HexabitzPlatform/H1DR2x-Hardware/README.md

# H1DR2x-Hardware
Hexabitz CAN Transceiver Module Hardware Design
