HexabitzPlatform/H1DR2x-Hardware/H1DR21/Released/BOM/H1DR21.xlsx

 |  | www.hexabitz.com info@hexabitz.com |  | Bill Of Materials
Customer | Hexabitz | Revision | 1
Project | Hexabitz Modules | Date | 2024-11-12
Board | 3.3V CAN Transceiver (H1DR2x) | Notes
Designator | Description | Manufacturer Part Number | Manufacturer | Octopart Url | Quantity
RESET | Headers & Wire Housings Unshrouded 1 POS T/H | 5-146280-1 | TE Connectivity | https://octopart.com/5-146280-1-te+connectivity+%2F+amp-40259676?r=sp | 1
SWD | Conn Unshrouded Header HDR 3 POS 2.54mm Solder ST Top Entry Thru-Hole Carton | 5-146281-3 | TE Connectivity | https://octopart.com/5-146281-3-te+connectivity+%2F+amp-39745942?r=sp | 1
R1 | RES SMD 0.0OHM JUMPER 1/10W 0603 | RC0603JR-070RL | YAGEO [VR] | https://octopart.com/rc0603jr-070rl-yageo-1241539?r=sp | 1
R4 | DNP RES 0 OHM JUMPER 1/10W 0603 | RC0603JR-070RL | Yageo | https://octopart.com/rc0603jr-070rl-yageo-1241539 | 1
R5 | RES SMD 120 OHM 1% 1/10W 0603 | AC0603FR-07120RL | Yageo | https://octopart.com/ac0603fr-07120rl-yageo-25738064 | 1
R2, R8, R9 | 270.0R Thick Film Resistors - SMD 0603 | RC0603FR-07270RL | Yageo | https://octopart.com/rc0603fr-07270rl-yageo-9288890?r=sp | 3
R3 | RES 10K Ohm 1% 0603 | CRCW060310K0JNEB | Vishay | https://octopart.com/crcw060310k0jneb-vishay+dale-46603268 | 1
C3,C5,C6, C10 | CAP CER 0.1UF 25V X7R 0603 | C0603C104K8RACTU | KEMET | https://octopart.com/c0603c104k8ractu-kemet-145075?r=sp&s=9bS9ASSwSEqMCE9KBEQZ0g | 4
C1 | CAP CER 1 UF 16V X7R 0805 | CC0805KKX7R7BB105 | YAGEO [VA] | https://octopart.com/cc0805kkx7r7bb105-yageo-8376555?r=sp | 1
C4 | CAP CER 4.7UF 25V X6S 0805 | GRM21BC81E475KA12L | Murata | https://octopart.com/grm21bc81e475ka12l-murata-10331911?r=sp&s=RY3qZSD8T6mG6TC9CHI5qQ | 1
FB1 | FERRITE BEAD 30 OHM 0603 1LN | MMZ1608Y300BTA00 | TDK | https://octopart.com/mmz1608y300bta00-tdk-7906990?r=sp | 1
D1 | LED Uni-Color Super Red 639nm 2-Pin Chip 0603(1608Metric) T/R | VLMS1300-GS08 | Vishay | https://octopart.com/vlms1300-gs08-vishay-21709201?r=sp | 1
D2 | LED Uni-Color Soft Orange 611nm 2-Pin Chip 0603(1608Metric) T/R | VLMY1300-GS08 | Vishay | https://octopart.com/vlmo1300-gs08-vishay-21709200?r=sp | 1
D3 | LED Uni-Color Soft Yellow 611nm 2-Pin Chip 0603(1608Metric) T/R | VLMY1300-GS08 | Vishay | https://octopart.com/vlmy1300-gs08-vishay-21709204?r=sp | 1
D5 | TVS DIODE 3,3V 10,9V SOD323 | CDSOD323-T03SC | Bourns | https://octopart.com/cdsod323-t03sc-bourns-10487153?r=sp | 1
U1 | MCU 32-bit ARM Cortex M0+ RISC 512KB Flash 1.8V/2.5V/3.3V 48-Pin UFQFPN EP Tray | STM32G0B1CEU6 | STMicroelectronics | https://octopart.com/stm32g0b1ceu6-stmicroelectronics-116363364?r=sp | 1
U2 | EAR99 TCAN334 Tape & Reel (TR) CANbus interface transceiver 120mV 1.45mm 1Mbps -40C~125C | TCAN334DCNT | Texas Instruments | https://octopart.com/tcan334dcnt-texas+instruments-70835167 | 1
P1 | Modular Terminal Block, 15A, 1 Row(s), 1 Deck(s) | 1546111-2 | TE Connectivity | https://octopart.com/1546111-2-te+connectivity-40393355 | 1
X1 | 8,0000MHZ 33pF SMD MURATA Resonators | CSTNE8M00G550000R0 | Murata | https://octopart.com/cstne8m00g550000r0-murata-91406934?r=sp | 1
