HexabitzPlatform/H1DR2x-Hardware/H1DR21/Documentation/H1DR21.pdf

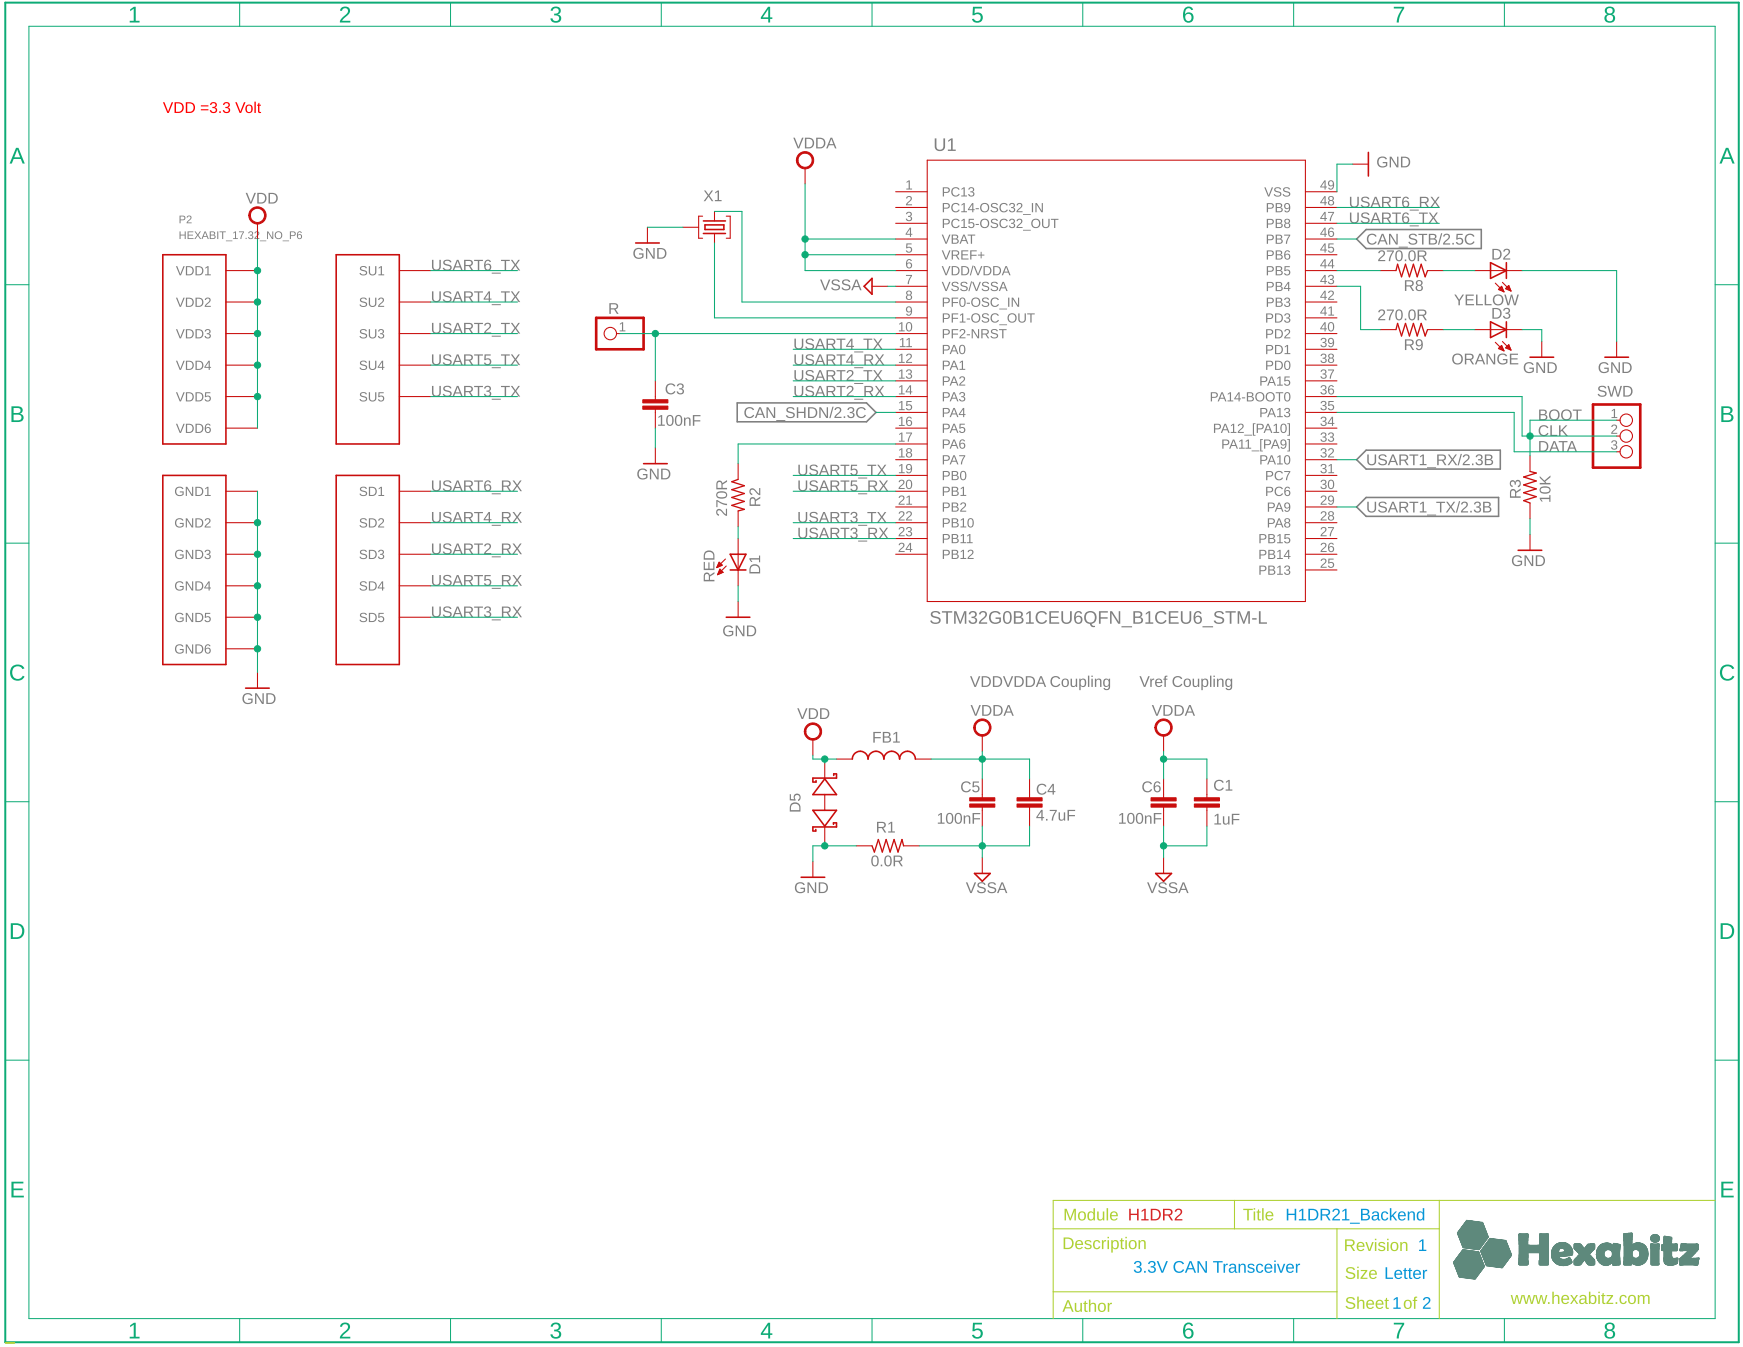
[picture p1: page 1]

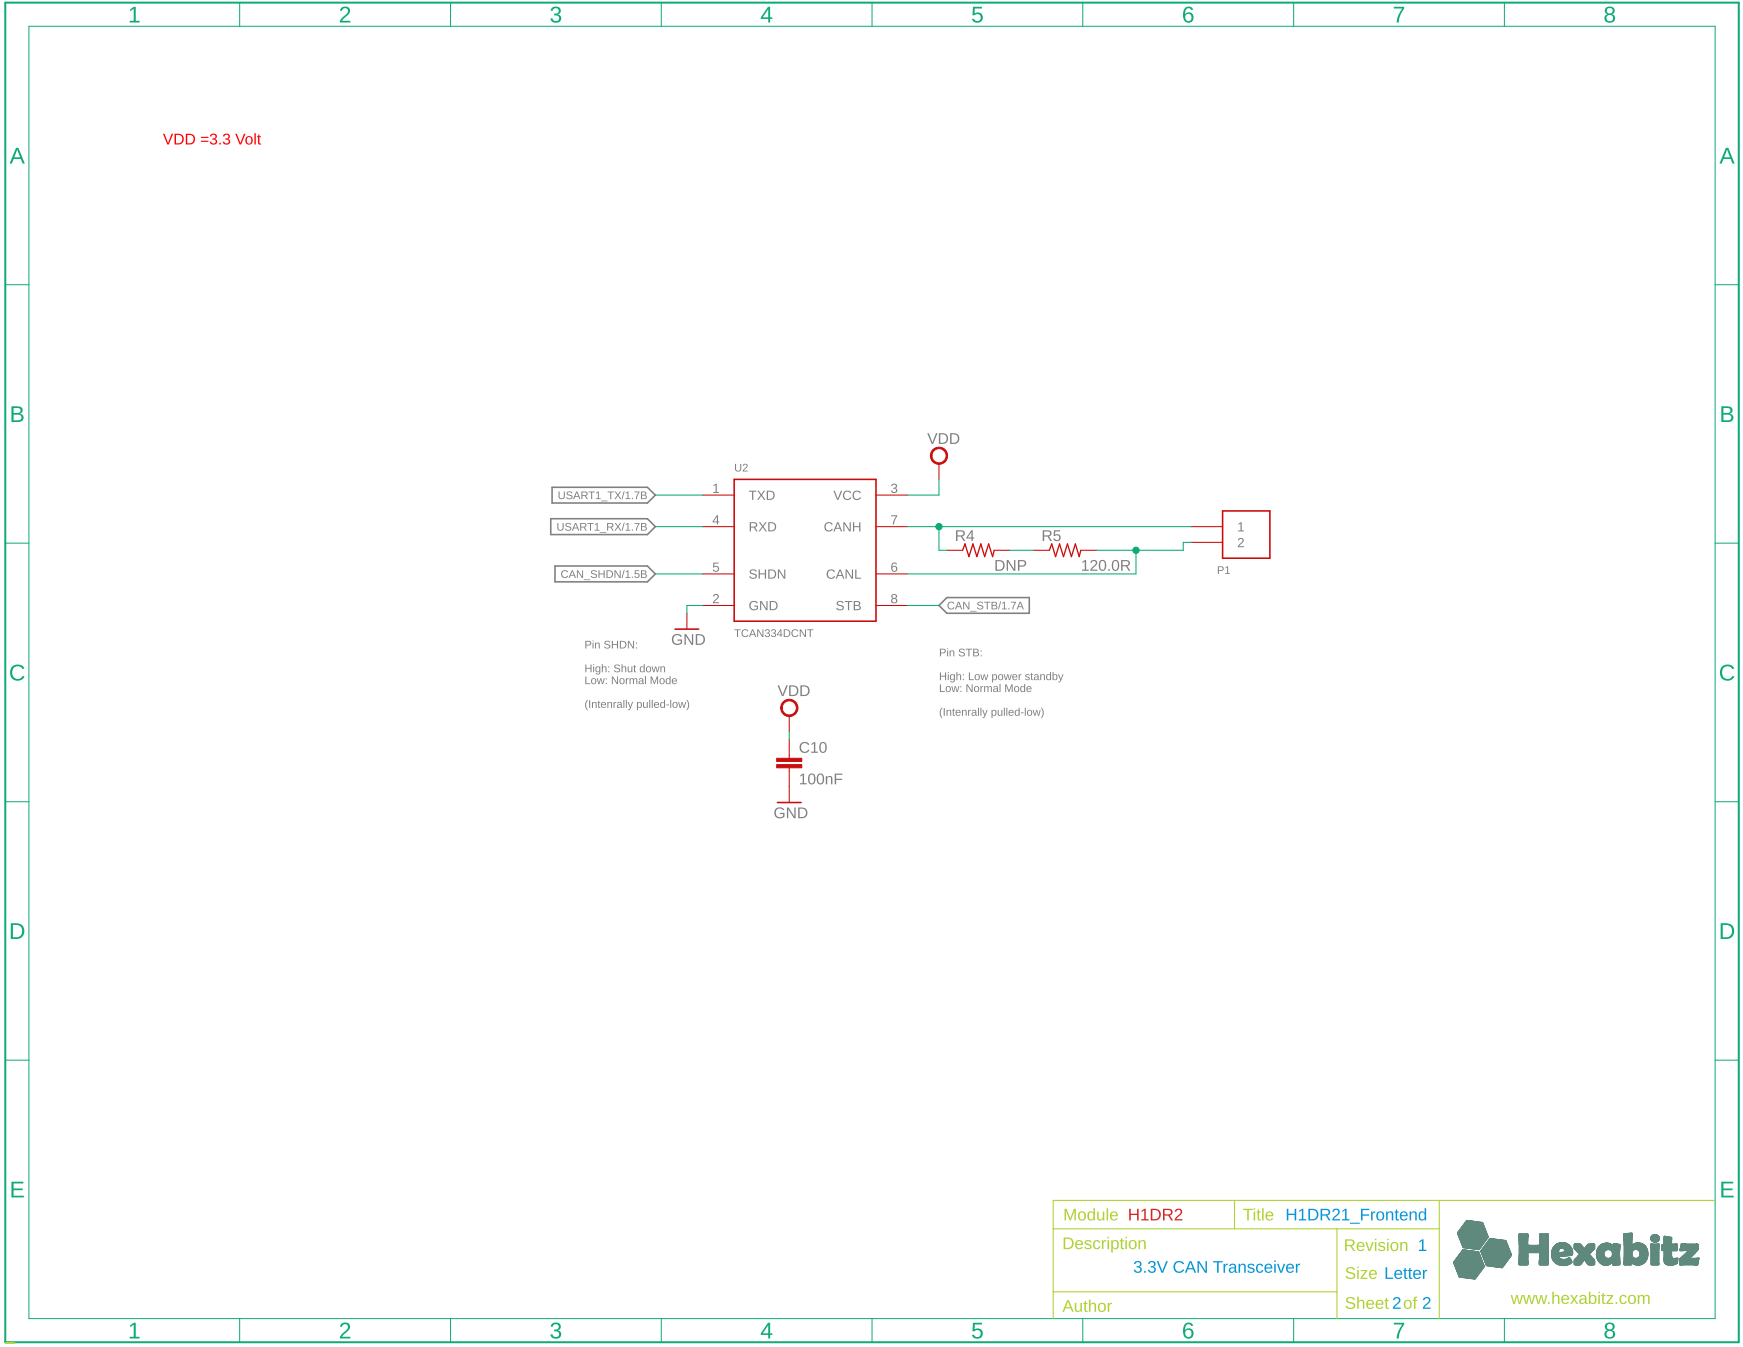
[picture p2: page 2]
