HexabitzPlatform/H1DR2x-Hardware/H1DR21/Design/H1DR21.brd

## EAGLE design H1DR21/Design/H1DR21.brd (2024-12-14)

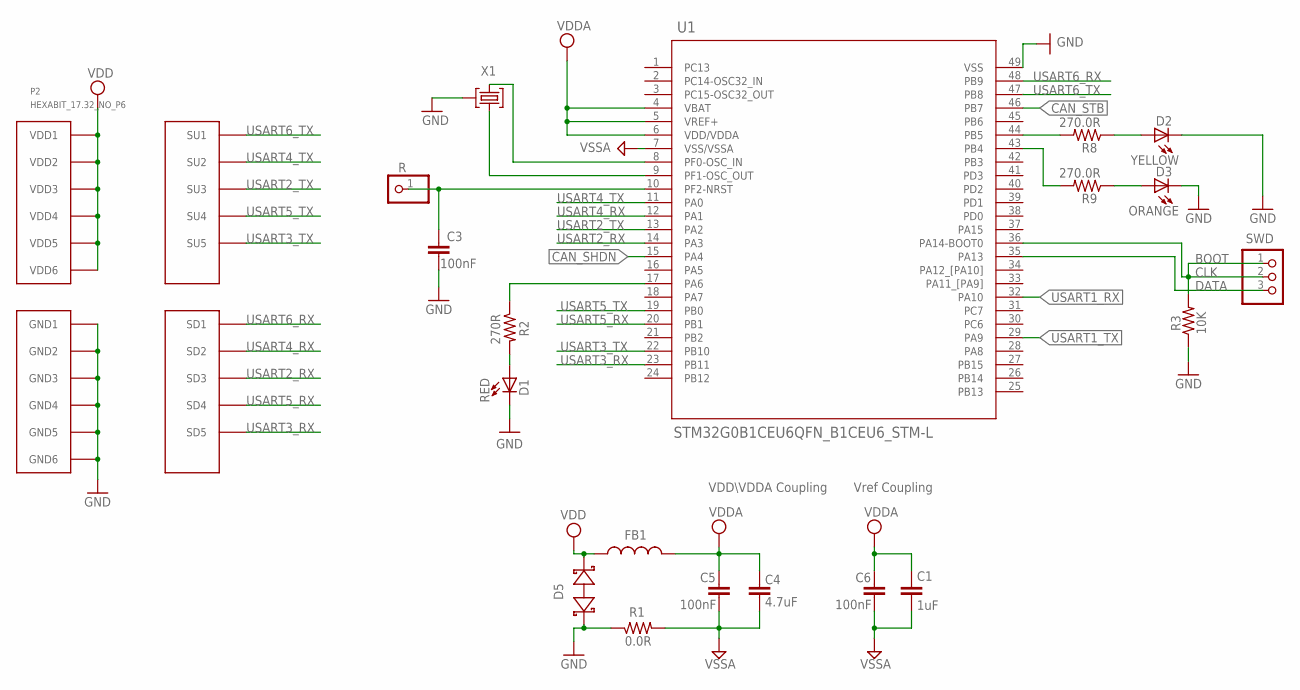
[picture p3: schematic H1DR21.sch, sheet 1]

Parts:
C1: 1uF; C-0805
C3, C5, C6: 100nF; C-0603
C4: 4.7uF; C-0805
D1: RED; VLMS1300-GS08; MPN VLMS1300-GS08
D2: YELLOW; VLMS1300-GS08
D3: ORANGE; VLMS1300-GS08
D5: BOURNS_CDSOD323-T03SCBOURNS_CDSOD323-T03SC_0_0; BOURNS_CDSOD323-T03SC_0
FB1: FB-TDK_MMZ1608Y300B; FB-0603; MPN MMZ1608Y300B
P2: HEXABIT_17.32_NO_P6
R: R; 1X01
R1: 0.0R; R-0603; MPN RC0603JR-070RL
R2: 270R; R-0603
R3: 10K; R-0603
R8, R9: 270.0R; R-0603
SWD: PINHD-1X3; 1X03
U1: STM32G0B1CEU6QFN_B1CEU6_STM-L; QFN_B1CEU6_STM-L
X1: XTALL_CSTCE8M00G52

Connections:
CAN_SHDN: U1.15 (PA4); also elsewhere on the board
CAN_STB: U1.46 (PB7); also elsewhere on the board
CLK: R3.2, SWD.1, SWD.2, U1.36 (PA14-BOOT0)
DATA: SWD.3, U1.35 (PA13)
GND: C3.2, D1.C, D2.C, D3.C, D5.1 (A), P2.PAD_PD7 (GND1), P2.PAD_PD8 (GND2), P2.PAD_PD9 (GND3), P2.PAD_PD10 (GND4), P2.PAD_PD11 (GND5), P2.PAD_PD12 (GND6), R1.1, R3.1, U1.49 (VSS), X1.P$2 (2); also elsewhere on the board
unnamed: D1.A, R2.2
unnamed: D3.A, R9.1
unnamed: R2.1, U1.17 (PA6)
unnamed: C3.1, R.1, U1.10 (PF2-NRST)
unnamed: U1.9 (PF1-OSC_OUT), X1.P$1 (1)
unnamed: U1.8 (PF0-OSC_IN), X1.P$3 (3)
unnamed: D2.A, R8.1
unnamed: R8.2, U1.44 (PB5)
unnamed: R9.2, U1.43 (PB4)
USART1_RX: U1.32 (PA10); also elsewhere on the board
USART1_TX: U1.29 (PA9); also elsewhere on the board
USART2_RX: P2.PAD_PD3 (SD3), U1.14 (PA3)
USART2_TX: P2.PAD_PU3 (SU3), U1.13 (PA2)
USART3_RX: P2.PAD_PD5 (SD5), U1.23 (PB11)
USART3_TX: P2.PAD_PU5 (SU5), U1.22 (PB10)
USART4_RX: P2.PAD_PD2 (SD2), U1.12 (PA1)
USART4_TX: P2.PAD_PU2 (SU2), U1.11 (PA0)
USART5_RX: P2.PAD_PD4 (SD4), U1.20 (PB1)
USART5_TX: P2.PAD_PU4 (SU4), U1.19 (PB0)
USART6_RX: P2.PAD_PD1 (SD1), U1.48 (PB9)
USART6_TX: P2.PAD_PU1 (SU1), U1.47 (PB8)
VDD: D5.2 (C), FB1.2, P2.PAD_PU7 (VDD1), P2.PAD_PU8 (VDD2), P2.PAD_PU9 (VDD3), P2.PAD_PU10 (VDD4), P2.PAD_PU11 (VDD5), P2.PAD_PU12 (VDD6); also elsewhere on the board
VDDA: C1.1, C4.1, C5.1, C6.1, FB1.1, U1.4 (VBAT), U1.5 (VREF+), U1.6 (VDD/VDDA)
VSSA: C1.2, C4.2, C5.2, C6.2, R1.2, U1.7 (VSS/VSSA)

Notes on the sheet:
Vref Coupling
VDD\VDDA Coupling
BOOT

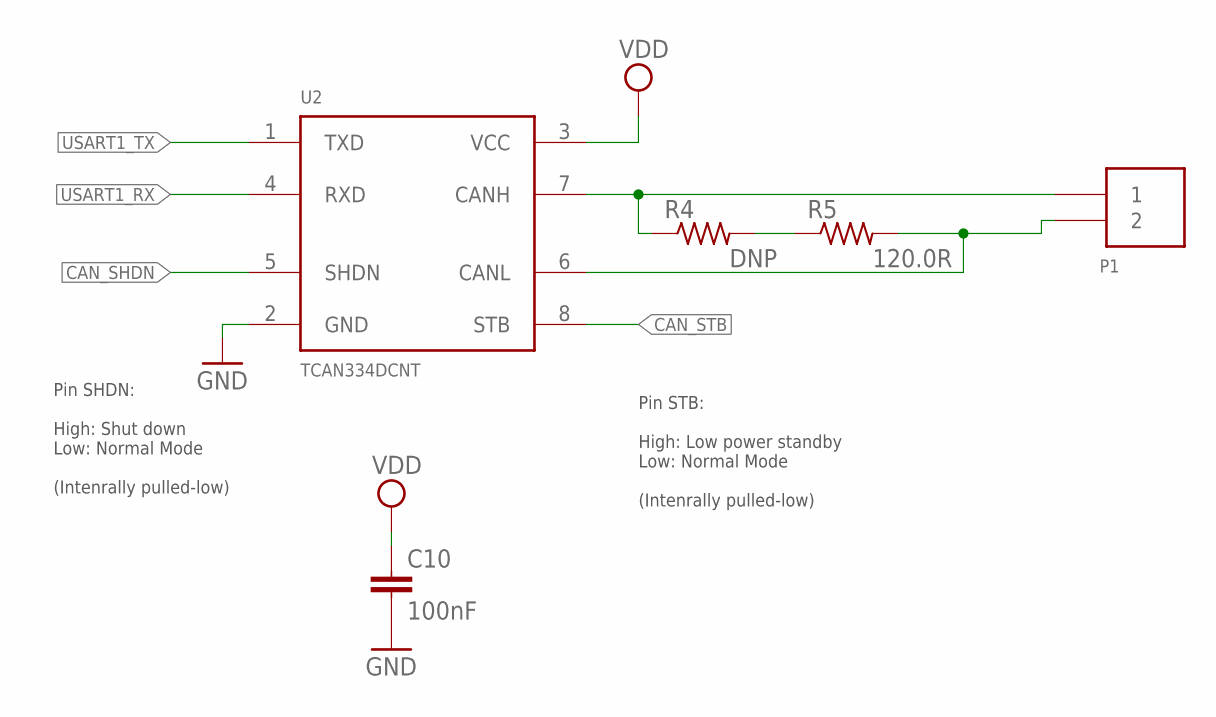
[picture p4: schematic H1DR21.sch, sheet 2]

Parts:
C10: 100nF; C-0603; TOLERANCE 10%; VOLTAGE_RATING 10V; MPN C0603C104K8RACTU
P1: 1546111-2
R4: DNP; R-0603; MPN RC0603JR-070RL
R5: 120.0R; R-0603; TOLERANCE 1%; MPN AC0603FR-07120RL
U2: TCAN334DCNT

Connections:
CAN_SHDN: U2.5 (SHDN); also elsewhere on the board
CAN_STB: U2.8 (STB); also elsewhere on the board
GND: C10.2, U2.2 (GND); also elsewhere on the board
unnamed: P1.1, R4.1, U2.7 (CANH)
unnamed: R4.2, R5.1
unnamed: P1.2, R5.2, U2.6 (CANL)
USART1_RX: U2.4 (RXD); also elsewhere on the board
USART1_TX: U2.1 (TXD); also elsewhere on the board
VDD: C10.1, U2.3 (VCC); also elsewhere on the board

Notes on the sheet:
Pin SHDN: High: Shut down Low: Normal Mode (Intenrally pulled-low)
Pin STB: High: Low power standby Low: Normal Mode (Intenrally pulled-low)

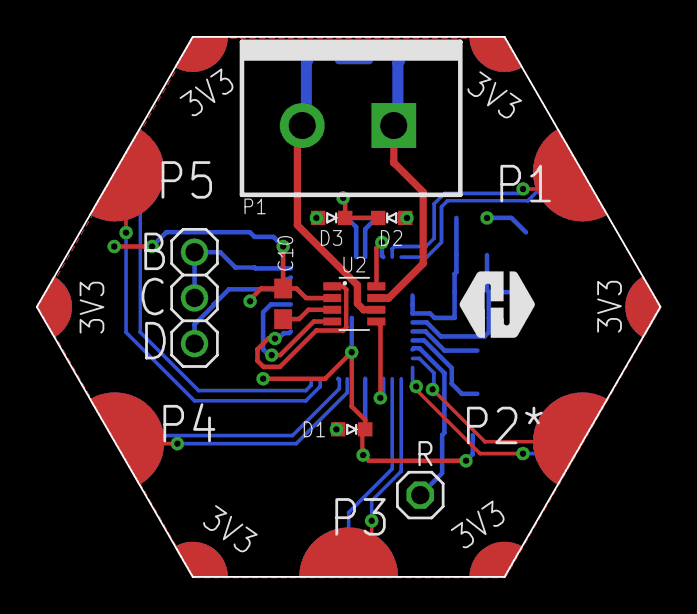
[picture p5: board H1DR21.brd from above]

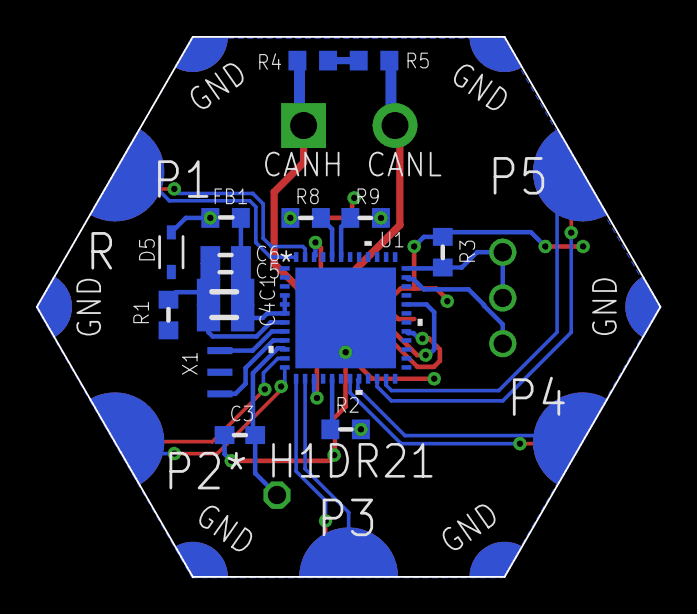
[picture p6: board H1DR21.brd from below]

Board: 2 copper layers, 34.6 x 30.0 mm, 26 parts (16 on the bottom side), 32 nets.

Other parts of the board:
U$1: HEXA-LOGO
