HexabitzPlatform/H1DR2x-Hardware/H1DR20/Design/H1DR20.sch

## EAGLE design H1DR20/Design/H1DR20.sch (2019-05-23)

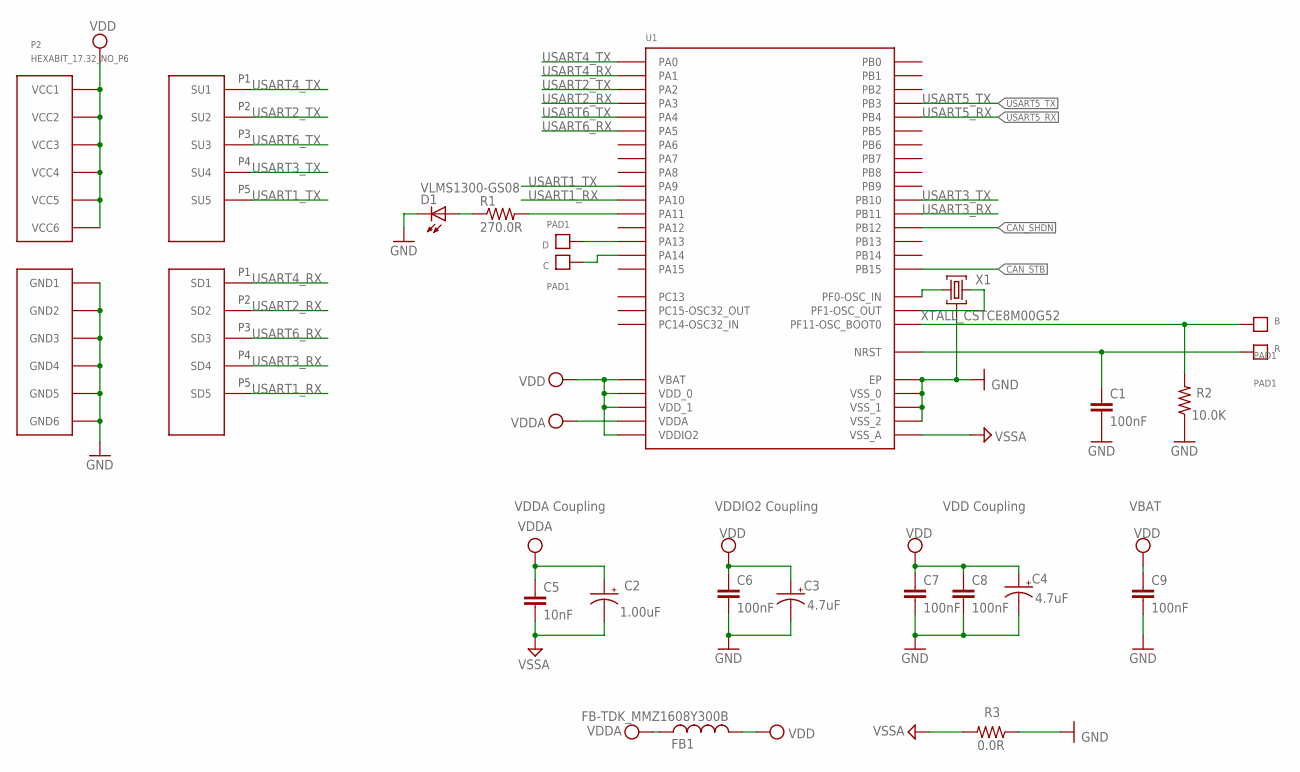
[picture p7: schematic H1DR20.sch, sheet 1]

Parts:
B: PAD1
C: PAD1
C1, C6, C8: 100nF; C-0603; TOLERANCE 10%; VOLTAGE_RATING 10V; MPN C0603C104K8RACTU
C2: 1.00uF; C-0805-POL; TOLERANCE 10%; VOLTAGE_RATING 16V; MPN CC0805KKX7R7BB105
C3, C4: 4.7uF; C-0805-POL; TOLERANCE 10%; VOLTAGE_RATING 25V; MPN GRM21BC81E475KA12L
C5: 10nF; C-0603; TOLERANCE 10%; VOLTAGE_RATING 50V; MPN C0603C103K5RACTU
C7: 100nF; C-0603; TOLERANCE 10%; VOLTAGE_RATING 10; MPN C0603C104K8RACTU
C9: 100nF; C-0603; TOLERANCE 10V; VOLTAGE_RATING 10%; MPN C0603C104K8RACTU
D: PAD1
D1: VLMS1300-GS08; MPN VLMS1300-GS08
FB1: FB-TDK_MMZ1608Y300B; MPN MMZ1608Y300B
P2: HEXABIT_17.32_NO_P6
R: PAD1
R1: 270.0R; R-0603; TOLERANCE 1%; MPN RC0603FR-07270RL
R2: 10.0K; R-0603; TOLERANCE 5%; MPN RC0603JR-0710KL
R3: 0.0R; R-0603; MPN RC0603JR-070RL
U1: STM32F091CBU6
X1: XTALL_CSTCE8M00G52

Connections:
B: B.P$1, R2.2, U1.P$44 (PF11-OSC_BOOT0)
CAN_SHDN: U1.P$25 (PB12)
CAN_STB: U1.P$28 (PB15)
GND: C1.2, C3.2 (-), C4.2 (-), C6.2, C7.2, C8.2, C9.2, D1.C, P2.7 (GND1), P2.8 (GND2), P2.9 (GND3), P2.10 (GND4), P2.11 (GND5), P2.12 (GND6), R2.1, R3.1, U1.EP, U1.P$23 (VSS_0), U1.P$35 (VSS_1), U1.P$47 (VSS_2), X1.P$2 (2)
unnamed: D.P$1, U1.P$34 (PA13)
unnamed: C.P$1, U1.P$37 (PA14)
unnamed: R1.2, U1.P$32 (PA11)
unnamed: D1.A, R1.1
unnamed: U1.P$5 (PF0-OSC_IN), X1.P$1 (1)
unnamed: U1.P$6 (PF1-OSC_OUT), X1.P$3 (3)
R: C1.1, R.P$1, U1.P$7 (NRST)
USART1_RX: P2.23 (SD5), U1.P$31 (PA10)
USART1_TX: P2.17 (SU5), U1.P$30 (PA9)
USART2_RX: P2.20 (SD2), U1.P$13 (PA3)
USART2_TX: P2.14 (SU2), U1.P$12 (PA2)
USART3_RX: P2.22 (SD4), U1.P$22 (PB11)
USART3_TX: P2.16 (SU4), U1.P$21 (PB10)
USART4_RX: P2.19 (SD1), U1.P$11 (PA1)
USART4_TX: P2.13 (SU1), U1.P$10 (PA0)
USART5_RX: U1.P$40 (PB4)
USART5_TX: U1.P$39 (PB3)
USART6_RX: P2.21 (SD3), U1.P$15 (PA5)
USART6_TX: P2.15 (SU3), U1.P$14 (PA4)
VDD: C3.1 (+), C4.1 (+), C6.1, C7.1, C8.1, C9.1, FB1.2, P2.1 (VCC1), P2.2 (VCC2), P2.3 (VCC3), P2.4 (VCC4), P2.5 (VCC5), P2.6 (VCC6), U1.P$1 (VBAT), U1.P$24 (VDD_0), U1.P$36 (VDDIO2), U1.P$48 (VDD_1)
VDDA: C2.1 (+), C5.1, FB1.1, U1.P$9 (VDDA)
VSSA: C2.2 (-), C5.2, R3.2, U1.P$8 (VSS_A)

Notes on the sheet:
VDDA Coupling
VDDIO2 Coupling
VDD Coupling
VBAT

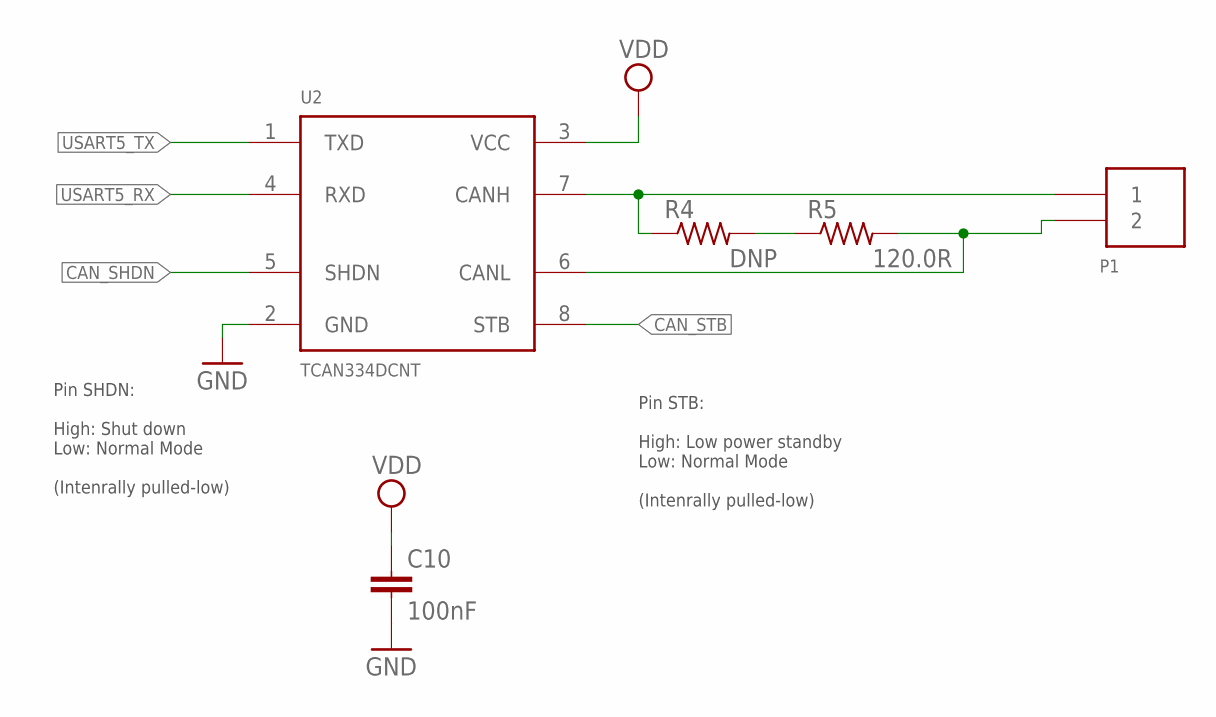
[picture p8: schematic H1DR20.sch, sheet 2]

Parts:
C10: 100nF; C-0603; TOLERANCE 10%; VOLTAGE_RATING 10V; MPN C0603C104K8RACTU
P1: 1546111-2
R4: DNP; R-0603; MPN RC0603JR-070RL
R5: 120.0R; R-0603; TOLERANCE 1%; MPN AC0603FR-07120RL
U2: TCAN334DCNT

Connections:
CAN_SHDN: U2.5 (SHDN)
CAN_STB: U2.8 (STB)
GND: C10.2, U2.2 (GND)
unnamed: P1.1, R4.1, U2.7 (CANH)
unnamed: R4.2, R5.1
unnamed: P1.2, R5.2, U2.6 (CANL)
USART5_RX: U2.4 (RXD)
USART5_TX: U2.1 (TXD)
VDD: C10.1, U2.3 (VCC)

Notes on the sheet:
Pin SHDN: High: Shut down Low: Normal Mode (Intenrally pulled-low)
Pin STB: High: Low power standby Low: Normal Mode (Intenrally pulled-low)
