HexabitzPlatform/H1DR2x-Hardware/(commit log)

2019-05-23 First release rev 0
    [H1DR20.brd, H1DR20.sch, H1DR20.xlsx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]
2024-12-11 - Changed MCU to G0 - New schematic design - New Layout - Generated documentation - Generated BOM - Deleted old output files (drills, gerber, pick and place)
    [H1DR20.brd, H1DR20.xlsx, H1DR21.brd, H1DR21.sch, H1DR21.xlsx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]
2024-12-12 - Changed USART routes width to 8mil
    [H1DR21.brd]
2024-12-14 - Rearranged components in BOM
    [H1DR21.xlsx]
2024-12-14 - Changed logo in layout - Rearranged components in BOM
    [H1DR21.brd, H1DR21.xlsx]
